JohnHuang16/hexapod/bom/Hexapod_BOM.xlsx

Hexapod — Bill of Materials
USD, as of Oct 24, 2026. Blue = editable. Set Include? to Y/N; totals update. 'Checked' = price seen on a live listing; 'Estimate' = typical price, confirm before buying.
# | Section | Item | Spec / Notes | Qty | Unit ($) | Include? | Line total ($) | Price basis | Where
1 | 1. Prototype leg | Hiwonder HTD-45H serial bus servo | 45 kg·cm stall @ 11.1 V, 9–12.6 V, metal gears, temp/voltage/position feedback | 3 | $29.99 | Y | $89.97 | Checked | Amazon (sold by Hiwonder-US, free 30-day returns)
2 | 1. Prototype leg | Hiwonder TTL/USB debugging board | Sets servo IDs, laptop control. Confirm HTD-series support on listing | 1 | $16.99 | Y | $16.99 | Checked | RobotShop / Amazon Hiwonder store
3 | 1. Prototype leg | 12 V power supply, 5 A+, 5.5 mm barrel | Desk power for the leg | 1 | $15.00 | Y | $15.00 | Estimate | Amazon
4 | 1. Prototype leg | Barrel jack → screw terminal adapter | Match to how the debug board takes power | 1 | $4.00 | Y | $4.00 | Estimate | Amazon
5 | 1. Prototype leg | Spare Hiwonder bus cable | Extra length to route along the leg | 1 | $5.00 | Y | $5.00 | Estimate | Amazon Hiwonder store
6 | 1. Prototype leg | Capacitor 1000 µF+, 25 V+ | Across servo power to absorb spikes | 1 | $2.00 | Y | $2.00 | Estimate | Amazon / DigiKey
7 | 1. Prototype leg | M3 screw + nut assortment kit |  | 1 | $12.00 | Y | $12.00 | Estimate | Amazon
8 | 1. Prototype leg | M3 heat-set inserts kit (brass, tapered) | M3×4–5 mm; kit with install tips preferred | 1 | $12.00 | Y | $12.00 | Estimate | Amazon
9 | 1. Prototype leg | Blue threadlocker (Loctite 243) | For horn screws | 1 | $6.00 | Y | $6.00 | Estimate | Amazon / Home Depot
10 | 1. Prototype leg | Bearings + M3/M4 shoulder bolts | ORDER AFTER CAD — size depends on servo rear mount | 1 | $15.00 | N | $0.00 | Estimate | Amazon / McMaster-Carr
11 | 1. Prototype leg | PETG filament, 1 kg | Skip if printing free at Jacobs Hall | 1 | $20.00 | Y | $20.00 | Estimate | Amazon / Bambu store
12 | 2. Tools | Soldering iron (Pinecil or basic station) | Adjustable temp; Pinecil needs 65 W+ USB-C PD charger | 1 | $35.00 | Y | $35.00 | Estimate | Amazon / Pine64
13 | 2. Tools | Soldering stand + brass tip cleaner | Skip if included with the iron | 1 | $10.00 | Y | $10.00 | Estimate | Amazon
14 | 2. Tools | Rosin-core solder, ~0.8 mm |  | 1 | $8.00 | Y | $8.00 | Estimate | Amazon
15 | 2. Tools | Multimeter | Skip if you have one | 1 | $20.00 | Y | $20.00 | Estimate | Amazon
16 | 2. Tools | Digital calipers | Measure servo + bearing fits for CAD | 1 | $20.00 | Y | $20.00 | Estimate | Amazon
17 | 2. Tools | Hex key / screwdriver set | Skip if you have one | 1 | $15.00 | N | $0.00 | Estimate | Amazon
18 | 3. Organization | Small-parts organizer, removable compartments | Screws, nuts, inserts, bearings | 1 | $12.00 | Y | $12.00 | Estimate | Amazon / Target
19 | 3. Organization | Silicone soldering mat | Heat-resistant desk protection | 1 | $12.00 | Y | $12.00 | Estimate | Amazon
20 | 3. Organization | 3-tier rolling cart | Tools + parts; NOT for the printer | 1 | $35.00 | Y | $35.00 | Estimate | Amazon / IKEA / Target
21 | 3. Organization | Lidded storage bin | For the leg between sessions | 1 | $10.00 | Y | $10.00 | Estimate | Target
22 | 4. 3D printer (optional) | Bambu Lab P2S (standalone) | Enclosed; spool holder mounts outside. Check Black Friday pricing + dorm rules | 1 | $549.00 | N | $0.00 | Checked | us.store.bambulab.com
23 | 4. 3D printer (optional) | Filament dry box | Keeps PETG dry | 1 | $30.00 | N | $0.00 | Estimate | Amazon
24 | 5. Phase 2 (later) | Hiwonder HTD-45H (remaining) | Brings total to 18; buy only after strength test passes | 15 | $29.99 | N | $0.00 | Checked | Amazon
25 | 5. Phase 2 (later) | Raspberry Pi 5, 2GB | List price as of Oct 1, 2026 | 1 | $77.50 | N | $0.00 | Checked | raspberrypi.com resellers
26 | 5. Phase 2 (later) | Pi Active Cooler + 64GB microSD |  | 1 | $17.00 | N | $0.00 | Estimate | Adafruit / Amazon
27 | 5. Phase 2 (later) | 3S LiPo ~5000 mAh, XT60 | Full charge 12.6 V matches servo range | 1 | $50.00 | N | $0.00 | Estimate | Amazon / hobby store
28 | 5. Phase 2 (later) | LiPo balance charger + safety bag |  | 1 | $60.00 | N | $0.00 | Estimate | Amazon
29 | 5. Phase 2 (later) | 5 V / 5 A buck converter | Powers the Pi from the battery | 1 | $12.00 | N | $0.00 | Estimate | Amazon
30 | 5. Phase 2 (later) | 30 A fuse + holder, kill switch | On main battery line | 1 | $18.00 | N | $0.00 | Estimate | Amazon
31 | 5. Phase 2 (later) | 14 AWG silicone wire + XT60 connectors |  | 1 | $15.00 | N | $0.00 | Estimate | Amazon
32 | 5. Phase 2 (later) | Body plates (aluminum or thick prints) | Top + bottom | 2 | $20.00 | N | $0.00 | Estimate | Amazon / SendCutSend
33 | 5. Phase 2 (later) | More filament (PETG/CF-nylon, 2 kg) |  | 1 | $40.00 | N | $0.00 | Estimate | Amazon
34 | 5. Phase 2 (later) | Bearings ×30 + screws/standoffs |  | 1 | $45.00 | N | $0.00 | Estimate | Amazon
 |  |  |  |  | Subtotals by section
 |  |  |  |  | 1. Prototype leg |  | $182.96
 |  |  |  |  | 2. Tools |  | $93.00
 |  |  |  |  | 3. Organization |  | $69.00
 |  |  |  |  | 4. 3D printer (optional) |  | $0.00
 |  |  |  |  | 5. Phase 2 (later) |  | $0.00
 |  |  |  |  | TOTAL (included) |  | $344.96
 |  |  |  |  | Full robot incl. Phase 2 (excl. printer) |  | $1199.31
