JohnHuang16/hexapod/cad/HTD-45H_placeholder.step

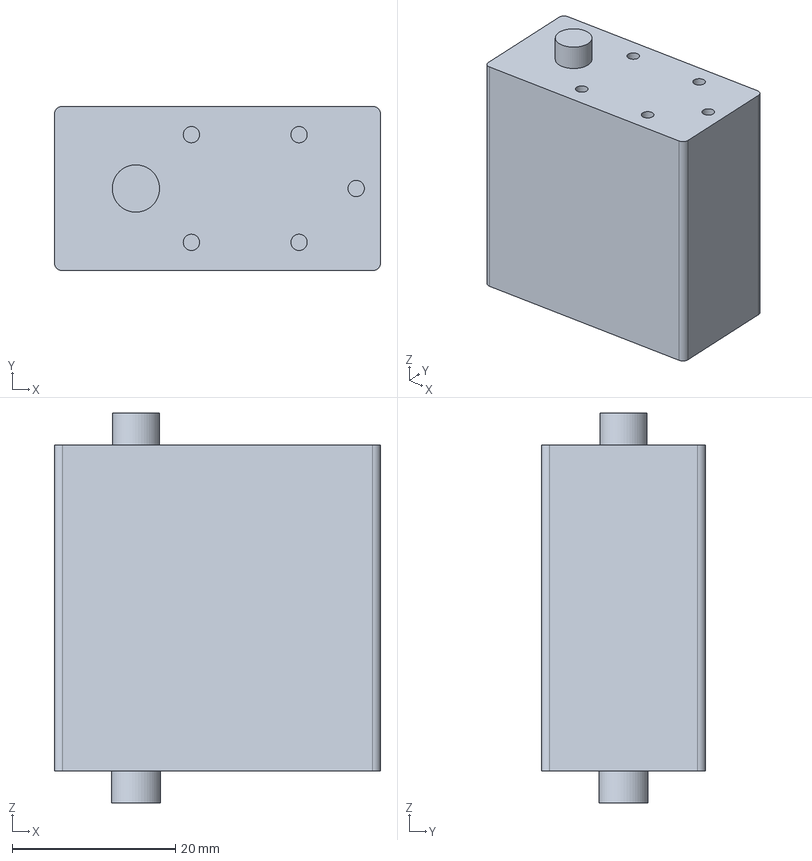
[picture p1: CAD file, 2026-10-26]
cad/HTD-45H_placeholder.step
40.0 x 20.1 x 47.8 mm
