JohnHuang16/hexapod/(commit log)

2026-10-26 Phase 1: servo bus code, kinematics and joint design notes, BOM, placeholder servo CAD
    Claude-Session: https://claude.ai/code/session_015Drv8Azqgvrw6U51idk5rB
    [HTD-45H_placeholder.step, Hexapod_BOM.xlsx]
2026-10-26 Add leg_ik.py: foot target -> joint angles -> servo positions, with calibration file
    Inverse and forward kinematics for one leg per docs/kinematics.md, reach and
    servo-range checks, per-joint calibration (ref_pos/ref_angle/sign/soft limits)
    in leg_cal.json, --move via the synchronized min-jerk SyncBus, and a self-test.
    Document the assembly convention: horns fitted at position 500 in the standing pose.
2026-10-27 Record horn fitting positions as servo references (429/459/500)
    New horns pressed on with the servos holding at coxa 429, femur 459,
    tibia 500; store those as ref_pos in leg_cal.json so the standing pose
    maps to them. Note in CLAUDE.md, plus the standing rule to push often.
2026-10-27 Add show_demo.py: exaggerated motion-profile show for bare servos
    Anticipation whip, elastic overshoot, crawl-then-slam, bounce, and a
    phase-shifted sine ripple that speeds up, centered on leg_cal.json
    reference positions, speed-limited by stretching each move.
    [show_demo.py]
2026-10-27 Note servo 2 runs hotter than 1 and 3 when holding unloaded
2026-10-27 Correct servo 2 heat note: caused by forcing it by hand, not the unit
2026-10-27 Add thermal baseline from identical 2-minute sweep on all three servos
2026-10-27 Switch motors off at the end of every script (ServoBus.release)
    Project rule: never leave servos holding after a run. leg_ik.py --move
    releases unless --hold is given.
2026-10-27 Calipers arrived; record servo body height spread 40.3-40.5 mm
2026-10-27 Decide servo pocket length 41.0 mm from measured 40.30-40.55 body spread
2026-11-03 Add teach_limits.py (learn joint range by hand); show_demo skips absent servos
    [show_demo.py, teach_limits.py]
2026-11-05 Calibrate coxa and femur by hand on the assembled leg; logger reconnects after USB drops
    coxa: 253 = straight out, sign -1, limits 30..680
    femur: 685 = horizontal, sign +1, limits 585..990 (desk limit)
    teach_limits.py survives BusLinker USB drops seen while back-driving servos fast.
2026-11-05 Add leg_demo.py: choreographed leg routine in joint angles within soft limits
    Look-around, accelerating stomps, elliptical walking stride, bow. Every target
    is range-checked through leg_cal.json before power.
2026-11-05 leg_demo: fix temperature print
    [leg_demo.py]
